IvanFeofanov/robot_mower/dock-station/charger.gif

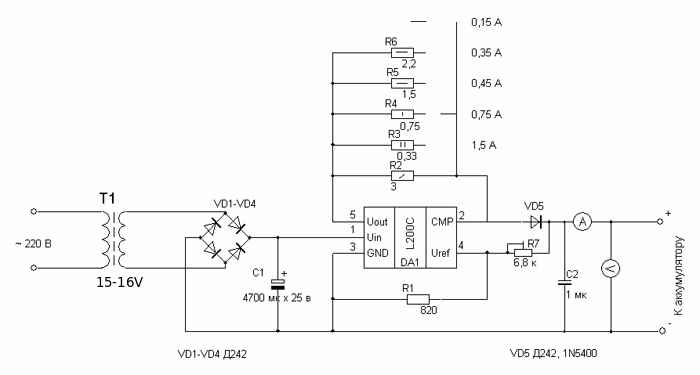
dock-station/charger.gif
