IvanFeofanov/robot_mower/perimeter_sensor/doc/result.xlsx

L | a | b | c
-45 | 242 | 217 | 191
-44 | 254 | 227 | 198
-43 | 273 | 234 | 205
-42 | 281 | 250 | 215
-41 | 297 | 265 | 228
-40 | 307 | 275 | 240
-39 | 326 | 290 | 251
-38 | 344 | 305 | 261
-37 | 352 | 320 | 276
-36 | 379 | 338 | 295
-35 | 401 | 356 | 309
-34 | 417 | 372 | 326
-33 | 441 | 397 | 335
-32 | 476 | 415 | 357
-31 | 504 | 440 | 387
-30 | 521 | 460 | 400
-29 | 558 | 490 | 418
-28 | 595 | 520 | 421
-27 | 632 | 570 | 445
-26 | 668 | 590 | 475
-25 | 707 | 625 | 495
-24 | 748 | 664 | 527
-23 | 805 | 740 | 556
-22 | 875 | 750 | 595
-21 | 905 | 810 | 625
-20 | 975 | 840 | 667
-19 | 1037 | 890 | 705
-18 | 1099 | 950 | 754
-17 | 1197 | 1087 | 795
-16 | 1287 | 1100 | 835
-15 | 1359 | 1155 | 891
-14 | 1427 | 1230 | 995
-13 | 1572 | 1315 | 1053
-12 | 1645 | 1400 | 1105
-11 | 1745 | 1460 | 1167
-10 | 1905 | 1540 | 1215
-9 | 2006 | 1600 | 1240
-8 | 2075 | 1640 | 1287
-7 | 2142 | 1670 | 1298
-6 | 2172 | 1650 | 1254
-5 | 2100 | 1570 | 1167
-4 | 1918 | 1460 | 1041
-3 | 1654 | 1250 | 850
-2 | 1175 | 915 | 285
-1 | 635 | 470 | 245
0 | 7 | 5 | 5
1 | 630 | 354 | 535
2 | 1218 | 770 | 918
3 | 1654 | 1080 | 1190
4 | 1945 | 1355 | 1380
5 | 2147 | 1523 | 1556
6 | 2218 | 1635 | 1650
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
