IvanFeofanov/robot_mower/perimeter_sensor/receiver/pcb/perimeter_sensor.brd

## EAGLE design perimeter_sensor/receiver/pcb/perimeter_sensor.brd (2017-02-14)

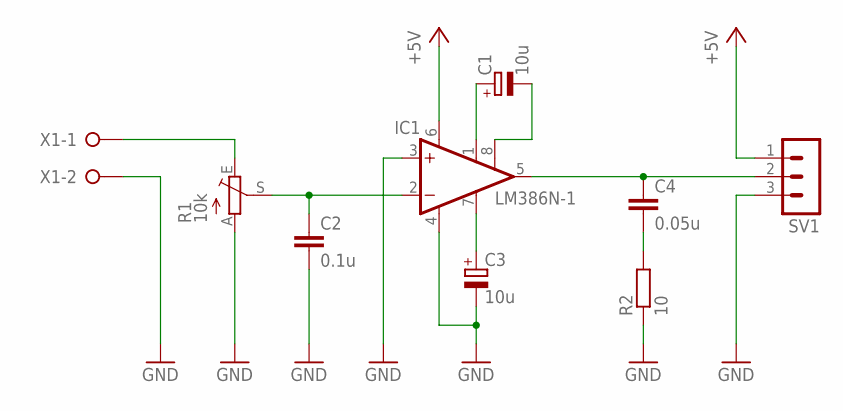
[picture p2: schematic perimeter_sensor.sch]

Parts:
C1, C3: 10u; E2,5-6
C2: 0.1u; C050-025X075
C4: 0.05u; C050-025X075
IC1: LM386N-1; DIL08
R1: 10k; S64W
R2: 10; 0204/7
SV1: MA03-1
X1: W237-02P; W237-132

Connections:
+5V: IC1.6 (VS), SV1.1
GND: C2.2, C3.-, IC1.3 (+IN), IC1.4 (GND), R1.A, R2.1, SV1.3, X1.2
unnamed: C1.-, IC1.8 (GAIN)
unnamed: C1.+, IC1.1 (GAIN)
unnamed: C3.+, IC1.7 (BYPASS)
unnamed: C2.1, IC1.2 (-IN), R1.S
unnamed: C4.1, IC1.5 (OUT), SV1.2
unnamed: C4.2, R2.2
unnamed: R1.E, X1.1

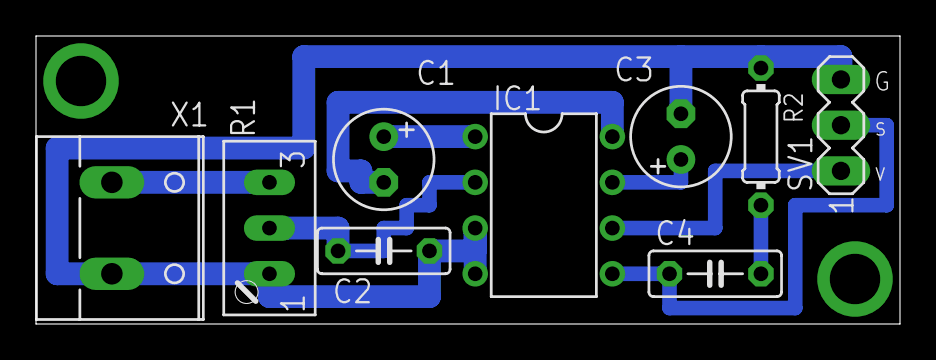
[picture p3: board perimeter_sensor.brd from above]

Board: 2 copper layers, 48.0 x 16.0 mm, 9 parts (0 on the bottom side), 9 nets.
