IvanFeofanov/robot_mower/motors_controller/pcb/motor_controller.brd

## EAGLE design motors_controller/pcb/motor_controller.brd (2017-02-14)

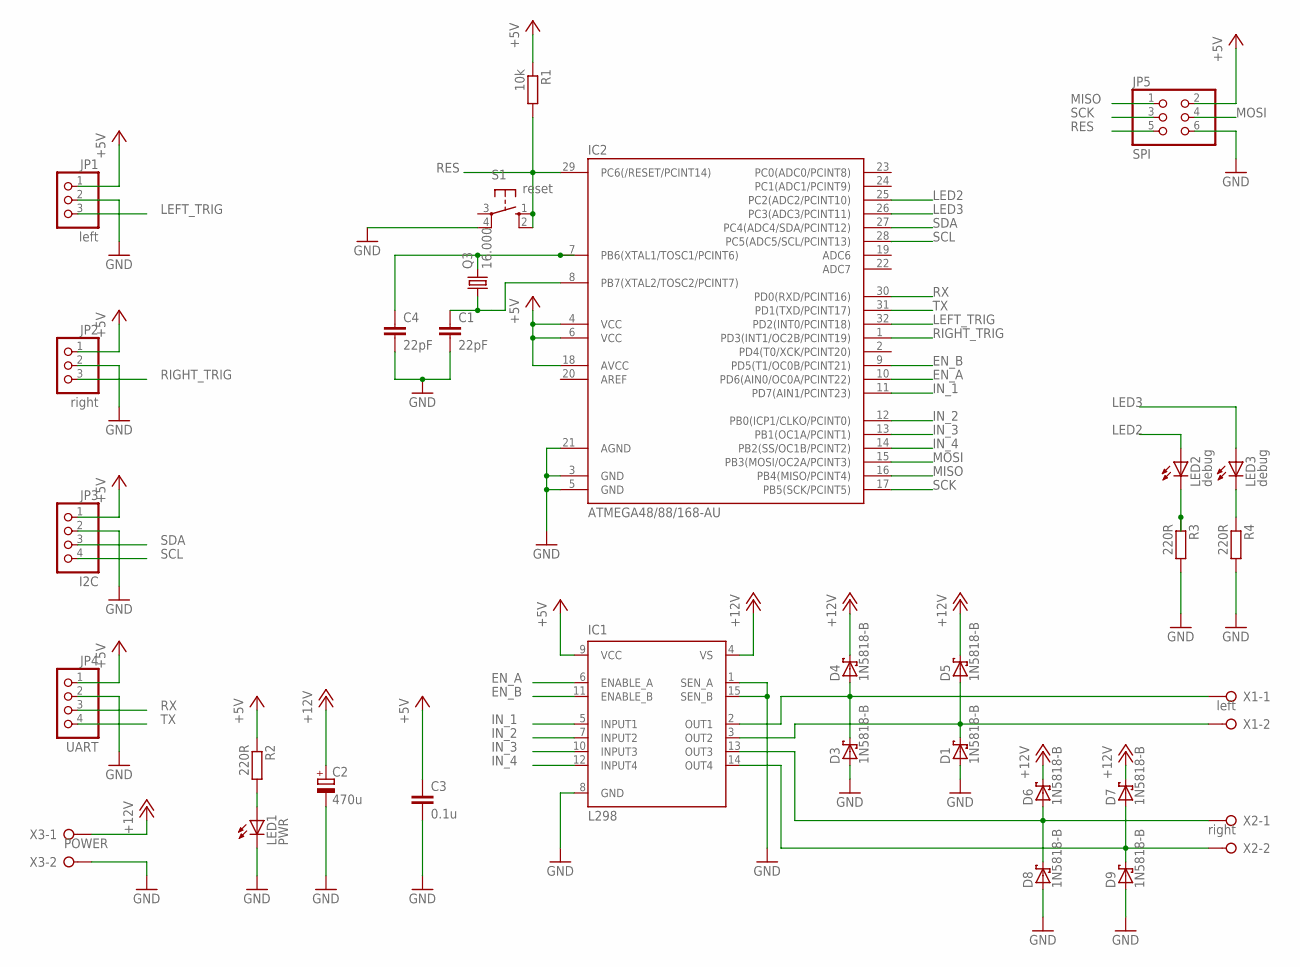
[picture p4: schematic motor_controller.sch]

Parts:
C1, C4: 22pF; C0805
C2: 470u; E5-10,5
C3: 0.1u; C0805
D1, D3, D4, D5, D6, D7, D8, D9: 1N5818-B; DO41-7.6
IC1: L298; MULTIWATT-15
IC2: ATMEGA48/88/168-AU; TQFP32-08
JP1: left; 1X03
JP2: right; 1X03
JP3: I2C; 1X04
JP4: UART; 1X04
JP5: SPI; 2X03
LED1: PWR; LED_1206
LED2, LED3: debug; LED_1206
Q3: 16.000; HC49UP
R1: 10k; R0805
R2, R3, R4: 220R; R0805
S1: reset; B3F-10XX
X1: left; W237-132
X2: right; W237-132
X3: POWER; W237-132

Connections:
+5V: C3.1, IC1.9 (VCC), IC2.4 (VCC), IC2.6 (VCC), IC2.18 (AVCC), JP1.1, JP2.1, JP3.1, JP4.1, JP5.2, R1.1, R2.1
+12V: C2.+, D4.C, D5.C, D6.C, D7.C, IC1.4 (VS), X3.1
EN_A: IC1.6 (ENABLE_A), IC2.10 (PD6(AIN0/OC0A/PCINT22))
EN_B: IC1.11 (ENABLE_B), IC2.9 (PD5(T1/OC0B/PCINT21))
GND: C1.2, C2.-, C3.2, C4.2, D1.A, D3.A, D8.A, D9.A, IC1.1 (SEN_A), IC1.8 (GND), IC1.15 (SEN_B), IC2.3 (GND), IC2.5 (GND), IC2.21 (AGND), JP1.2, JP2.2, JP3.2, JP4.2, JP5.6, LED1.C, R3.2, R4.2, S1.4 (P1), X3.2
IN_1: IC1.5 (INPUT1), IC2.11 (PD7(AIN1/PCINT23))
IN_2: IC1.7 (INPUT2), IC2.12 (PB0(ICP1/CLKO/PCINT0))
IN_3: IC1.10 (INPUT3), IC2.13 (PB1(OC1A/PCINT1))
IN_4: IC1.12 (INPUT4), IC2.14 (PB2(SS/OC1B/PCINT2))
LED2: IC2.25 (PC2(ADC2/PCINT10)), LED2.A
LED3: IC2.26 (PC3(ADC3/PCINT11)), LED3.A
LEFT_TRIG: IC2.32 (PD2(INT0/PCINT18)), JP1.3
MISO: IC2.16 (PB4(MISO/PCINT4)), JP5.1
MOSI: IC2.15 (PB3(MOSI/OC2A/PCINT3)), JP5.4
unnamed: LED1.A, R2.2
unnamed: C4.1, IC2.7 (PB6(XTAL1/TOSC1/PCINT6)), Q3.2
unnamed: C1.1, IC2.8 (PB7(XTAL2/TOSC2/PCINT7)), Q3.1
unnamed: LED3.C, R4.1
unnamed: LED2.C, R3.1
unnamed: D3.C, D4.A, IC1.2 (OUT1), X1.1
unnamed: D1.C, D5.A, IC1.3 (OUT2), X1.2
unnamed: D7.A, D9.C, IC1.14 (OUT4), X2.2
unnamed: D6.A, D8.C, IC1.13 (OUT3), X2.1
RES: IC2.29 (PC6(/RESET/PCINT14)), JP5.5, R1.2, S1.1 (S), S1.2 (S1)
RIGHT_TRIG: IC2.1 (PD3(INT1/OC2B/PCINT19)), JP2.3
RX: IC2.30 (PD0(RXD/PCINT16)), JP4.3
SCK: IC2.17 (PB5(SCK/PCINT5)), JP5.3
SCL: IC2.28 (PC5(ADC5/SCL/PCINT13)), JP3.4
SDA: IC2.27 (PC4(ADC4/SDA/PCINT12)), JP3.3
TX: IC2.31 (PD1(TXD/PCINT17)), JP4.4

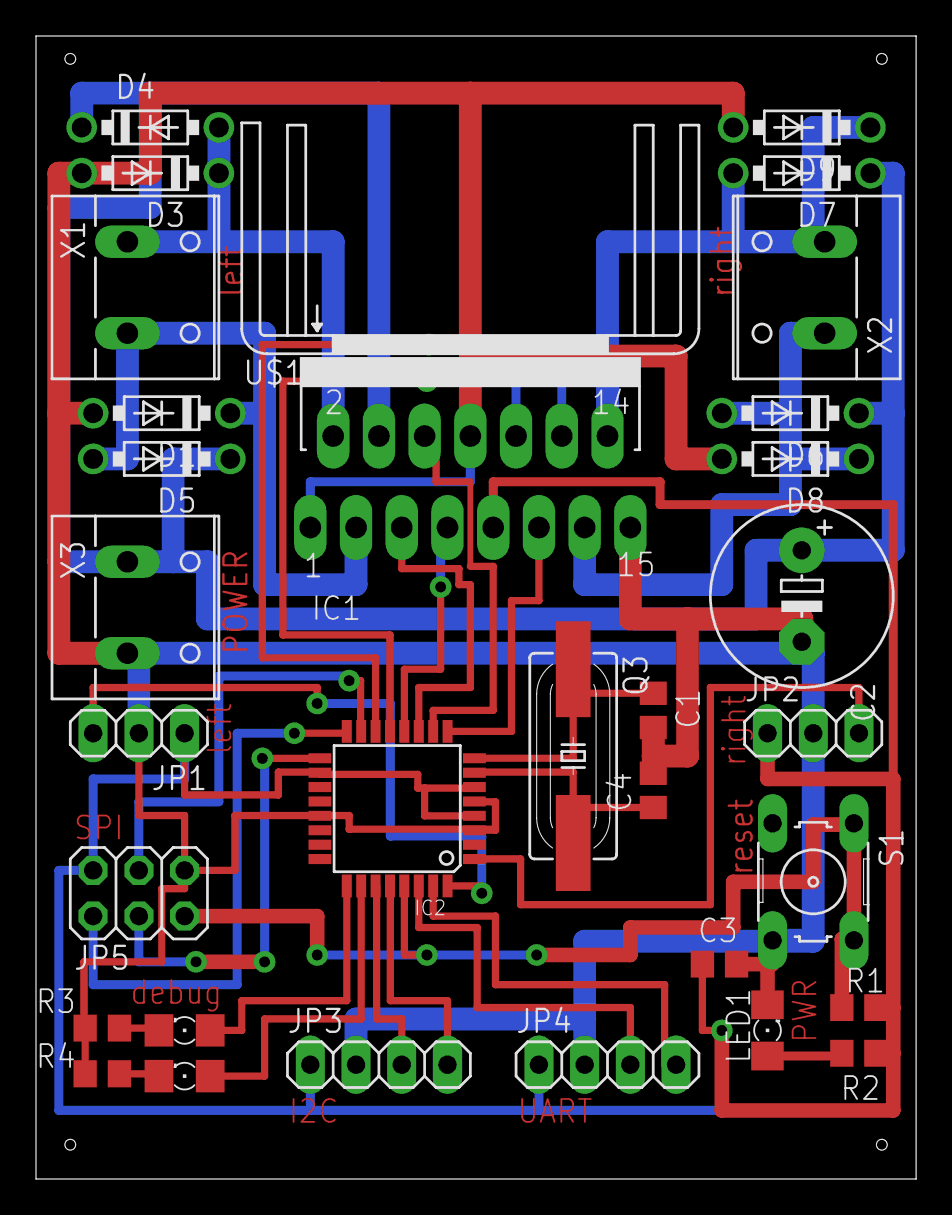
[picture p5: board motor_controller.brd from above]

Board: 2 copper layers, 48.9 x 63.5 mm, 32 parts (0 on the bottom side), 30 nets.

Other parts of the board:
U$1: FK213
