IvanFeofanov/robot_mower/perimeter_sensor/receiver/code/tests/adc_man.cpp

#include "adc_man.h"

volatile int16_t AdcMan::capture_value[CAPTURE_SIZE];
volatile uint16_t AdcMan::capture_counter;
volatile bool AdcMan::is_capture_complate;


ISR(ADC_vect)
{
    AdcMan::adcCallback();
}

void AdcMan::init()
{
    adc_init();

    capture_counter = 0;
    is_capture_complate  = false;

}

void AdcMan::start()
{
    is_capture_complate = false;
}

void AdcMan::adc_init()
{
    ADMUX |= (1<<REFS0) //voltage reference - AVcc
          | (1<<MUX0); //input channel ADC1

    ADCSRA |= (1<<ADEN)      // ADC enable
           | (1<<ADIE)       // interrupt enable
           | (1<<ADATE);     // auto trigger Enable

    //prescaler selection
    if(SAMPLE_RATE == 19231)
        ADCSRA |= (1<<ADPS2) | (1<<ADPS1) | (0<<ADPS0); //64
    else if(SAMPLE_RATE == 38462)
        ADCSRA |= (1<<ADPS2) | (0<<ADPS1) | (1<<ADPS0); //32
    else //9615
        ADCSRA |= (1<<ADPS2) | (1<<ADPS1) | (1<<ADPS0); //128

    ADCSRA |= (1<<ADSC); //start conv

}

void AdcMan::adcCallback()
{
    if(!is_capture_complate)
    {
        capture_value[capture_counter] = ADC;

        if(capture_counter + 1 < CAPTURE_SIZE){
            capture_counter++;
        }else{
            capture_counter = 0;
            is_capture_complate = true;
        }
    }
}

bool AdcMan::isCaptureComplate()
{
    return is_capture_complate;
}
