IvanFeofanov/robot_mower/(commit log)

2016-11-20 Added calculation of coil
    [coil_2_calc.ods, coil_3_calc.ods, coil_calc.ods]
2016-11-20 Added calculation of the current sensor
    [calc.ods]
2016-11-26 Added current sensor program for microcontrollers
2016-12-05 Added charging station scheme
2016-12-08 Added motor drive and terminal class
2016-12-09 Added class of system timer
2016-12-11 Added class of pid regulator
2016-12-28 added the PID controller configuration interface
2016-12-30 Rename drive_motor to the motor
2017-01-03 Fixed pid regulator
2017-01-13 Added driver of TWI
2017-01-19 Added saving system of PID controller settings
2017-01-20 Changed the way the sensors survey
2017-02-01 Added fuse bits for atmega88pa
2017-02-01 Fixed a bug int the PID
    [main.cpp, odometers.h]
2017-02-08 Добавлены средства индикации и контроля работы
2017-02-08 Добавлен блок управления двигателями косилки
2017-02-09 Добавлен модуль управления приводными двигателями
2017-02-12 Добавлен uart интерфей для контроля и отладки
2017-02-14 Добавлен код опроса бампера
2017-02-14 Renamed from odometers to motors_controller
2017-02-14 Added pcb for motors controller
    [motor_controller.brd, motor_controller.sch]
2017-02-14 Added pcb for receiver of the perimeter sensor
    [perimeter_sensor.brd, perimeter_sensor.sch]
2017-02-17 Добавлен код датчика периметра
2017-02-17 Added arduino-version of sender
2017-02-24 Добавилены данные тестов катушек для датчика периметра
    [coil_2_calc.ods, coil_3_calc.ods, coil_A.xlsx, coil_B.xlsx, coil_C.xlsx, coil_calc.ods, result.xlsx]
2017-02-25 Исправлены ошибки в прошивке контроллера двигателей
    [odometers.h, twi_slave.h]
2017-02-26 Добавлен алгоритм следования вдоль периметра
2017-03-28 Переделан алгоритм движения вдоль периметра.
2017-03-29 Переписаны автоматы бампера, индикатора и датчика периметра
2017-04-05 Переписан автомат косилки
2017-04-08 Добавлен шаблон автомата опроса тактовой кнопки
2017-04-23 Переделан автомат управление управления приводными двигателями
2017-05-06 Добавлено средство отладки
2017-07-23 Начал переделывать контроллер двигателей
2017-08-12 Добавлен SPI slave интерфейс
2017-08-12 -Удалили не используемые файлы twi интерфейса -Переделал контроллер двигателей
2017-08-17 Начал разработку SPI face
2017-08-19 Добавил драйвер SPI master
2017-08-20 Передалал DriveMotors под SPI интерфейс
2017-08-21 Доработал spi slave interface, освободил линию SS контроллера. Необходимо добавить новую схему платы двигателей и переделать ее разводку.
2017-08-22 Добавил контрольную сумму на передачу данных по SPI
2017-08-22 Исправлен баг в Flag
2017-08-23 Добавил контрольную сумму в MotorsController
2017-08-23 Перенес вывод управления на PIND3
2017-09-17 Сделал новый twi_face
2017-09-17 Заменил вывод управлени двигателем С5 на B2
2017-09-17 Удалил исходники spi интерфейса
2017-09-27 Новый Twi Master в главном контроллере
2017-09-30 Новый MotorsController
